Naman1177/WIFI_CRO/circuit_image.png

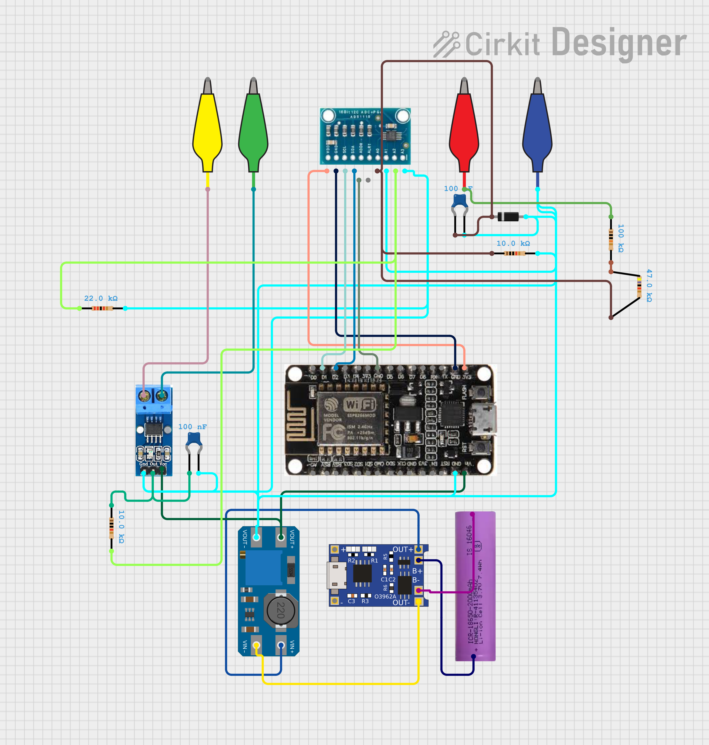
circuit_image.png
